datdo-is-coding/BEARING-CLASSIFICATION-SYSTEM/hardware/cad/models/tool.SLDASM

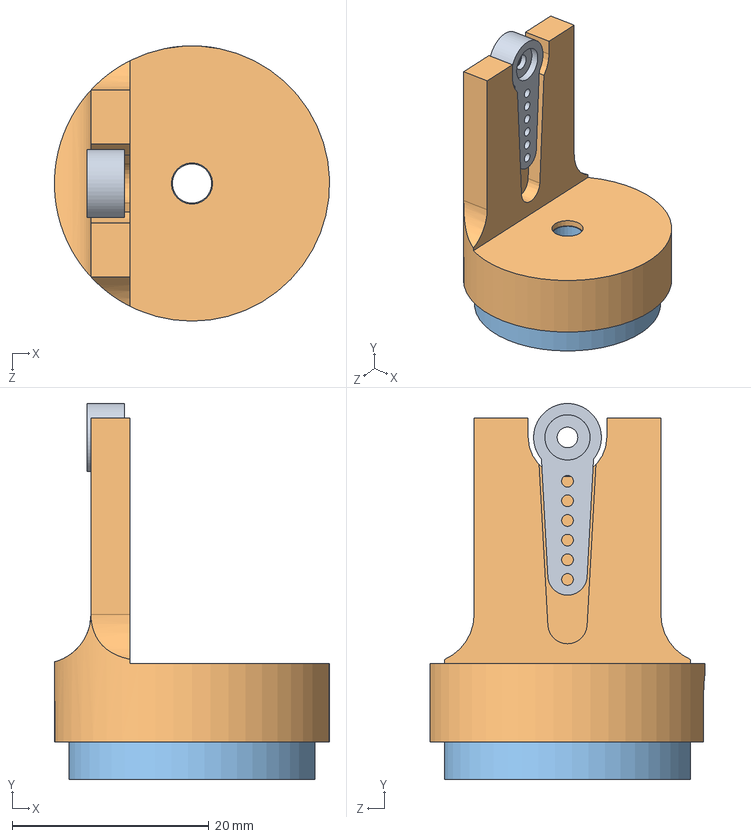
[picture p46: CAD file, 2026-10-25]
hardware/cad/models/tool.SLDASM
28.0 x 38.2 x 28.0 mm
SG90 - Micro Servo 9g - Tower Pro.2
arm4-1
magnet
