datdo-is-coding/BEARING-CLASSIFICATION-SYSTEM/hardware/cad/models/link3.SLDASM

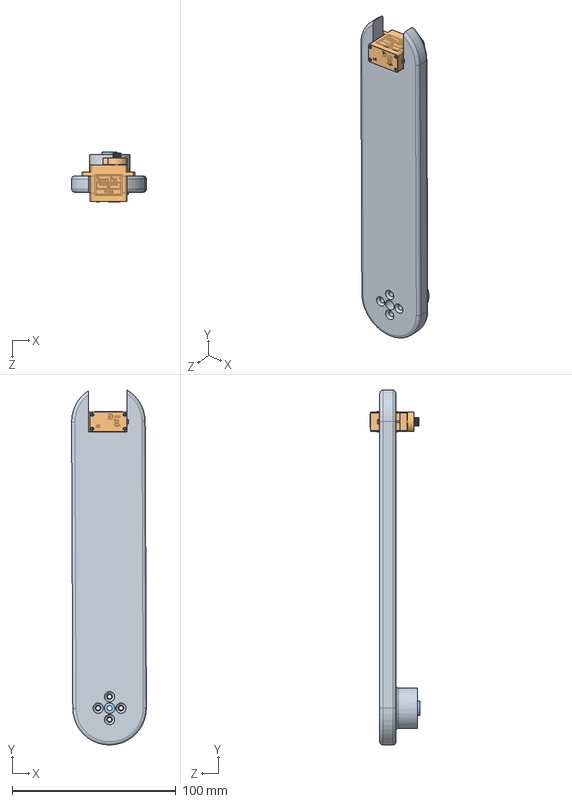
[picture p47: CAD file, 2026-10-25]
hardware/cad/models/link3.SLDASM
45.7 x 216.9 x 30.3 mm
arm bar
SG90 - Micro Servo 9g - Tower Pro.1
Servo horn v2.step
