datdo-is-coding/BEARING-CLASSIFICATION-SYSTEM/hardware/cad/models/link2.SLDASM

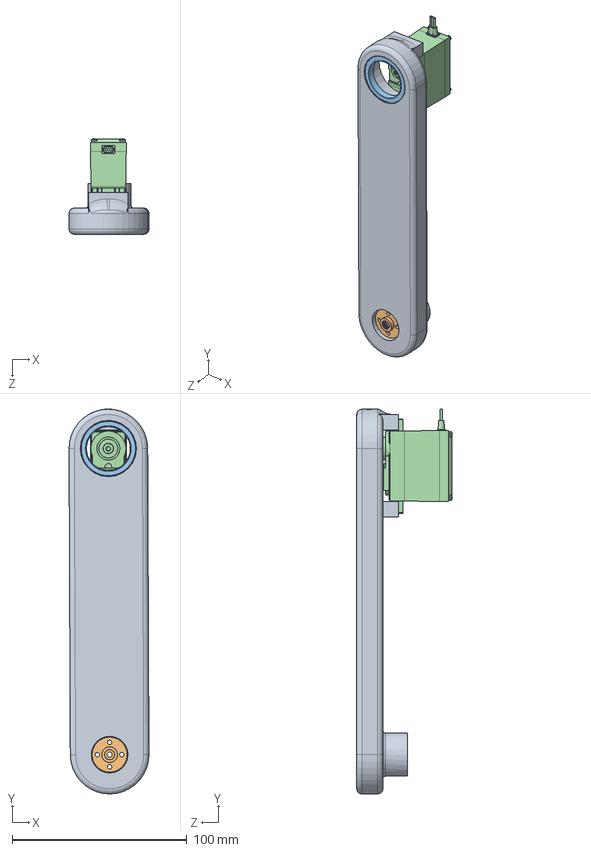
[picture p48: CAD file, 2026-10-25]
hardware/cad/models/link2.SLDASM
45.7 x 220.1 x 54.7 mm
arm bar
Servo horn v2.step
25x32x4
mg996R_v2
