datdo-is-coding/BEARING-CLASSIFICATION-SYSTEM/hardware/cad/link1.SLDASM

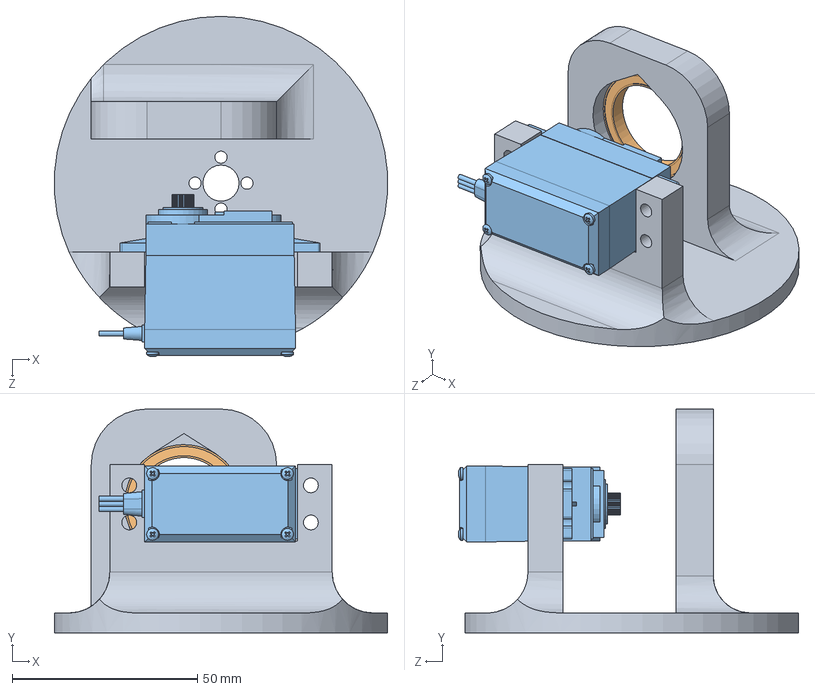
[picture p49: CAD file, 2026-10-25]
hardware/cad/link1.SLDASM
89.8 x 60.4 x 91.8 mm
arm2
25x32x4
mg996R_v2
