datdo-is-coding/BEARING-CLASSIFICATION-SYSTEM/hardware/cad/models/base_asm.SLDASM

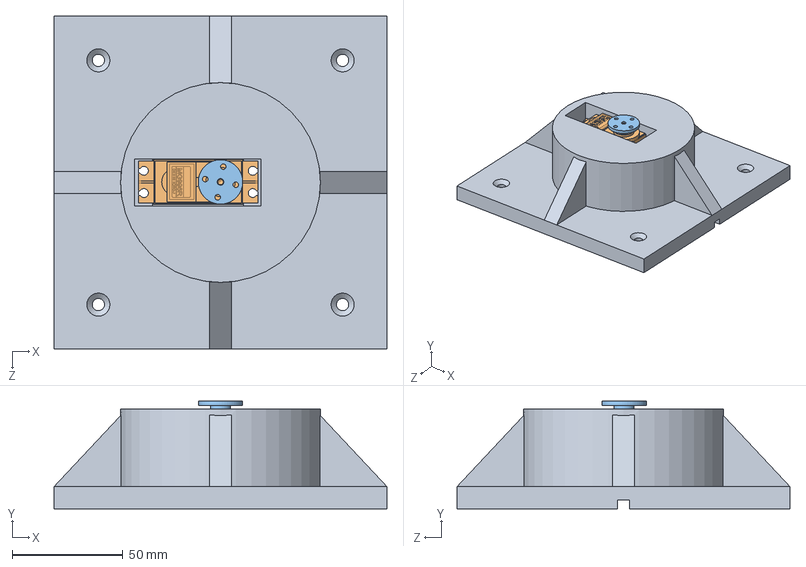
[picture p50: CAD file, 2026-10-25]
hardware/cad/models/base_asm.SLDASM
150.0 x 48.5 x 150.0 mm
base
mg996R_v2
Servo horn v2.step
