datdo-is-coding/BEARING-CLASSIFICATION-SYSTEM/hardware/cad/models/base_asm - Servo horn v2.step-1.STL

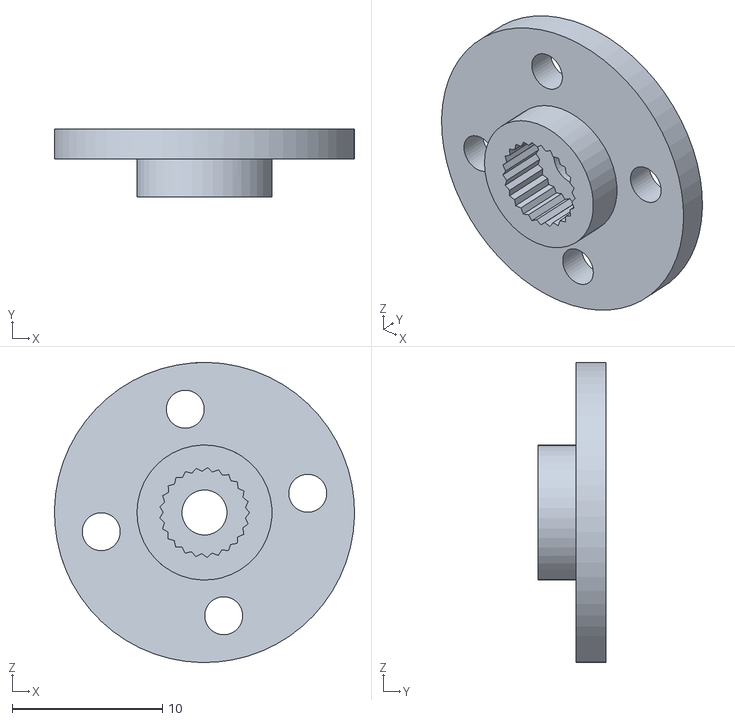
[picture p51: CAD file, 2026-10-25]
hardware/cad/models/base_asm - Servo horn v2.step-1.STL
20.0 x 4.50 x 20.0
