datdo-is-coding/BEARING-CLASSIFICATION-SYSTEM/hardware/cad/models/base_asm - mg996R_v2-1.STL

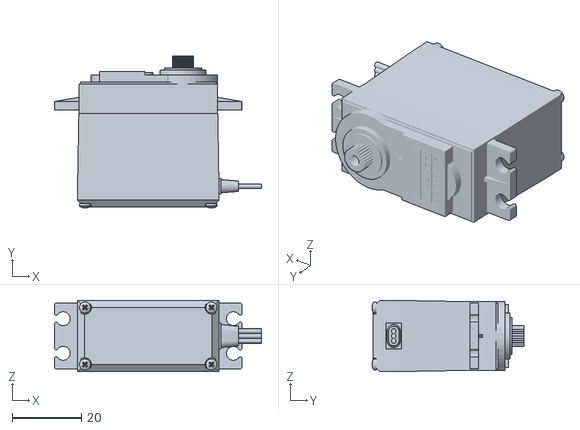
[picture p52: CAD file, 2026-10-25]
hardware/cad/models/base_asm - mg996R_v2-1.STL
59.6 x 43.8 x 20.5
