datdo-is-coding/BEARING-CLASSIFICATION-SYSTEM/hardware/cad/Assem1.SLDASM

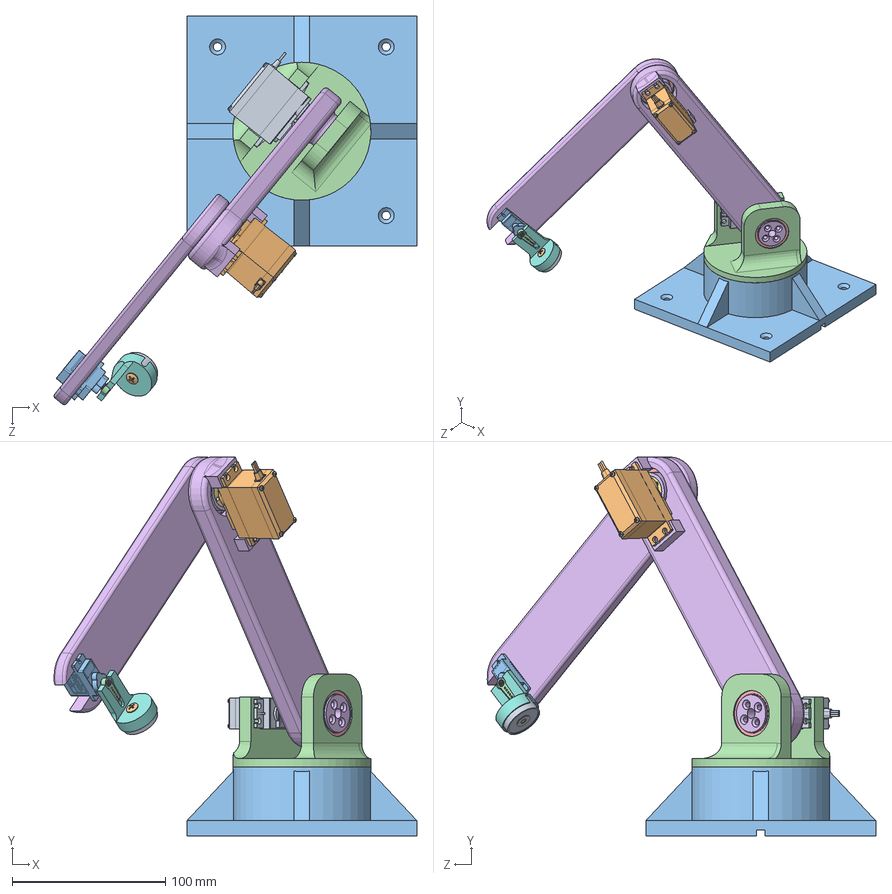
[picture p53: CAD file, 2026-10-25]
hardware/cad/Assem1.SLDASM
236.6 x 247.2 x 253.4 mm
mg996R_v2.step x 2
base
mg996R_v2
arm2
25x32x4 x 2
arm bar x 2
Servo horn v2.step x 3
arm4-1
magnet
countersunk raised head cross recess screw_iso
SG90 - Micro Servo 9g - Tower Pro.1_Pe_a.STEP
SG90 - Micro Servo 9g - Tower Pro.2_Pe_a.STEP
SG90 - Micro Servo 9g - Tower Pro.6_BS EN ISO 7045 - M2 x 4 - Z - 4S.STEP
