datdo-is-coding/BEARING-CLASSIFICATION-SYSTEM/hardware/cad/models/base_asm - base-1.STL

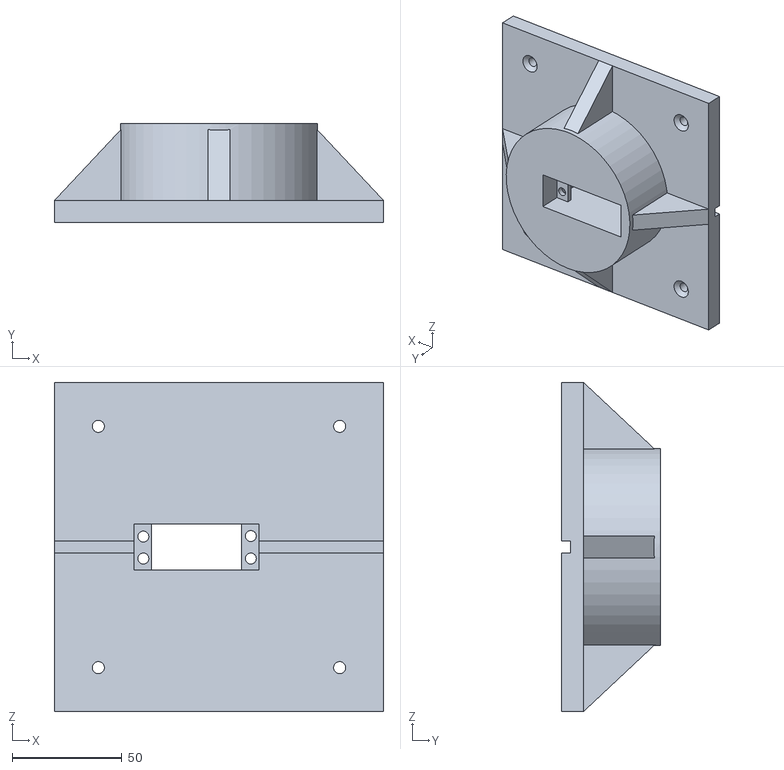
[picture p54: CAD file, 2026-10-25]
hardware/cad/models/base_asm - base-1.STL
150.0 x 45.0 x 150.0
