datdo-is-coding/BEARING-CLASSIFICATION-SYSTEM/hardware/cad/SG90.SLDASM

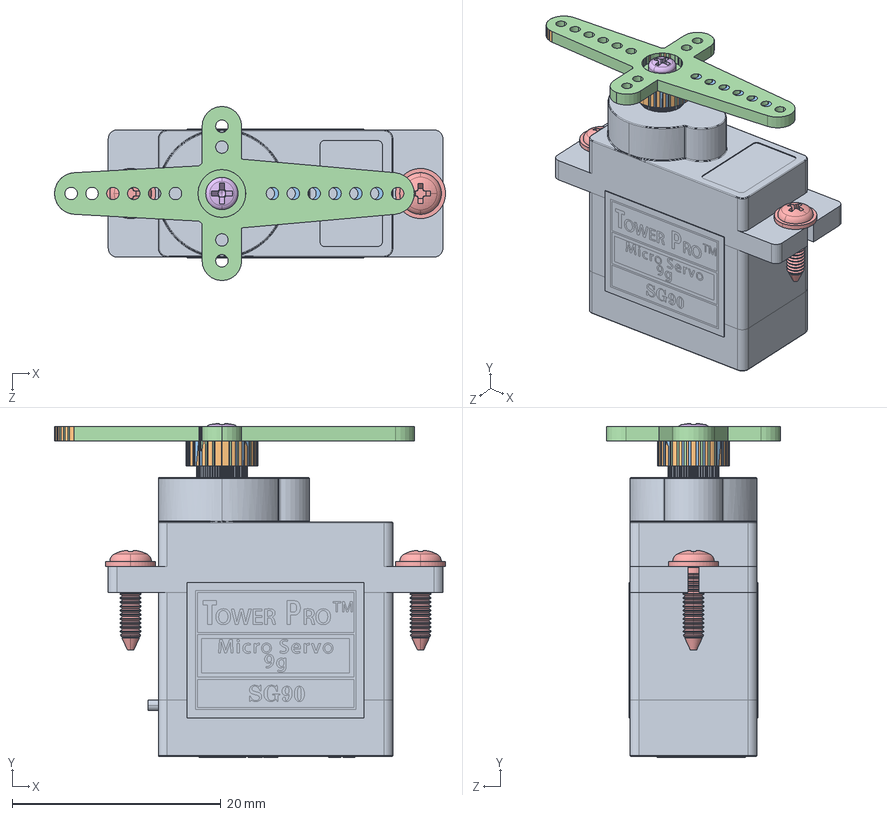
[picture p55: CAD file, 2026-10-25]
hardware/cad/SG90.SLDASM
37.5 x 32.0 x 16.7 mm
SG90 - Micro Servo 9g - Tower Pro.1_Pe_a.STEP
SG90 - Micro Servo 9g - Tower Pro.2_Pe_a.STEP
SG90 - Micro Servo 9g - Tower Pro.3_Pe_a.STEP
SG90 - Micro Servo 9g - Tower Pro.4_Pe_a.STEP
SG90 - Micro Servo 9g - Tower Pro.5_BS EN ISO 7045 - M2 x 8 - Z - 8S.STEP x 2
SG90 - Micro Servo 9g - Tower Pro.6_BS EN ISO 7045 - M2 x 4 - Z - 4S.STEP
