datdo-is-coding/BEARING-CLASSIFICATION-SYSTEM/hardware/cad/Assem2.SLDASM

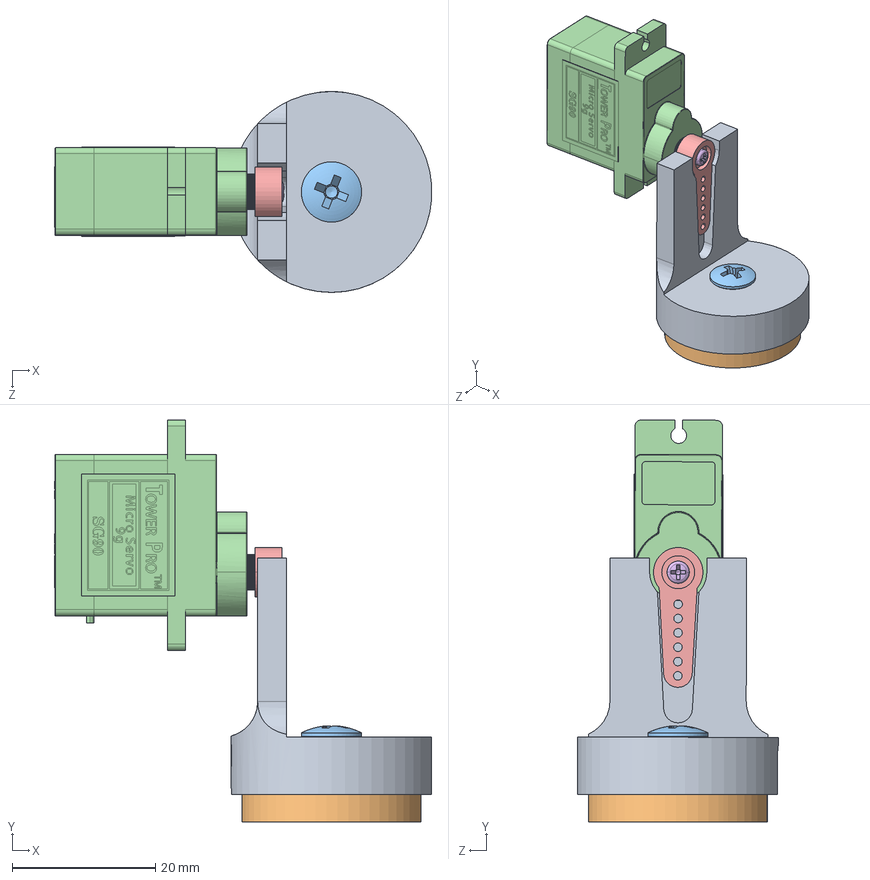
[picture p56: CAD file, 2026-10-25]
hardware/cad/Assem2.SLDASM
52.6 x 56.0 x 28.0 mm
arm4-1
magnet
countersunk raised head cross recess screw_iso
SG90 - Micro Servo 9g - Tower Pro.1_Pe_a.STEP
SG90 - Micro Servo 9g - Tower Pro.2_Pe_a.STEP
SG90 - Micro Servo 9g - Tower Pro.6_BS EN ISO 7045 - M2 x 4 - Z - 4S.STEP
