datdo-is-coding/BEARING-CLASSIFICATION-SYSTEM/hardware/cad/bearing_backward.SLDPRT

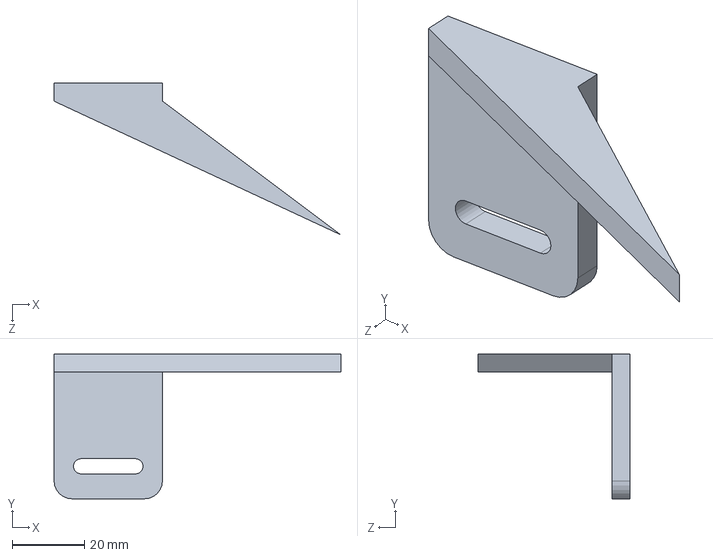
[picture p57: CAD file, 2026-11-04]
hardware/cad/bearing_backward.SLDPRT
79.3 x 40.0 x 42.0 mm
