datdo-is-coding/BEARING-CLASSIFICATION-SYSTEM/hardware/pcb/BIENDANG.DXF

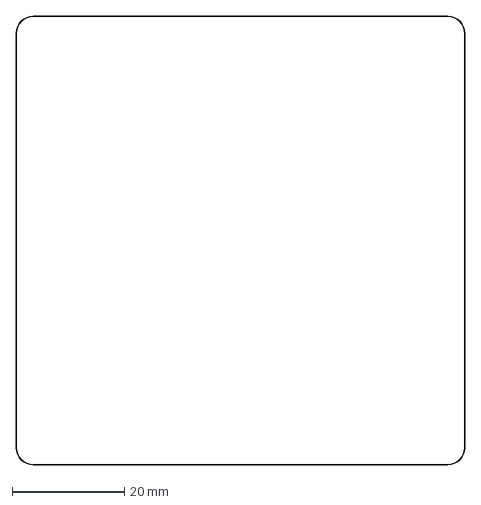
[picture p59: CAD file, 2026-10-25]
hardware/pcb/BIENDANG.DXF
80.0 x 80.0 mm
