datdo-is-coding/BEARING-CLASSIFICATION-SYSTEM/hardware/cad/bearing_.SLDPRT

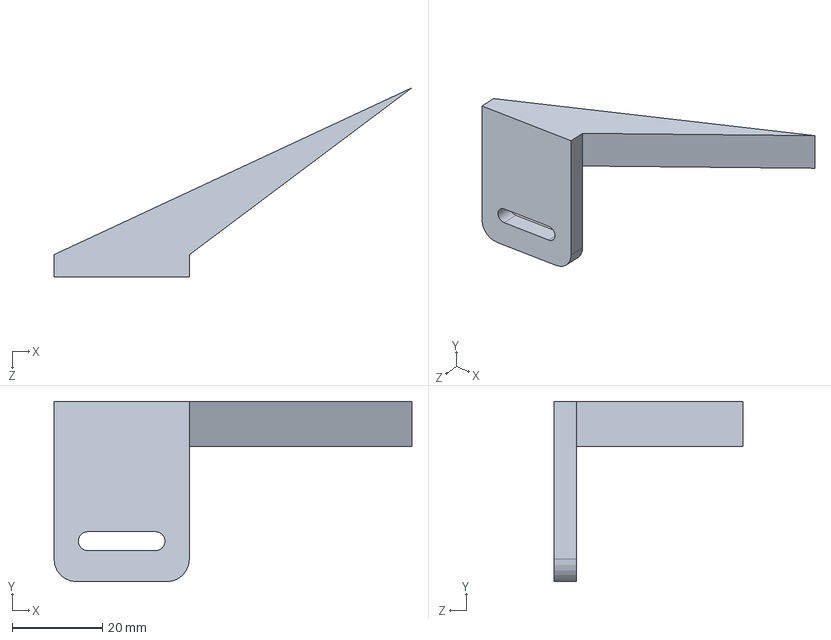
[picture p60: CAD file, 2026-11-04]
hardware/cad/bearing_.SLDPRT
79.3 x 40.0 x 42.0 mm
