datdo-is-coding/BEARING-CLASSIFICATION-SYSTEM/hardware/cad/arm bar.SLDPRT

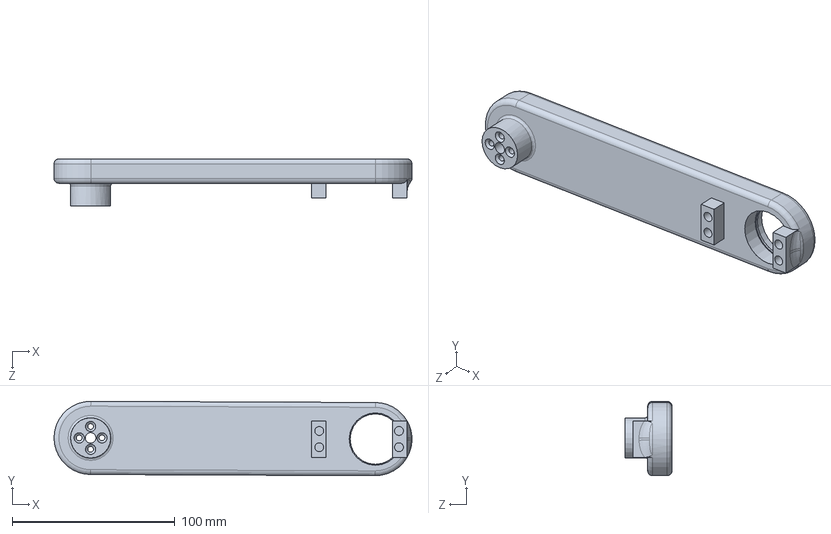
[picture p62: CAD file, 2026-10-25]
hardware/cad/arm bar.SLDPRT
220.0 x 45.7 x 29.0 mm
