datdo-is-coding/BEARING-CLASSIFICATION-SYSTEM/hardware/cad/25x32x4.SLDPRT

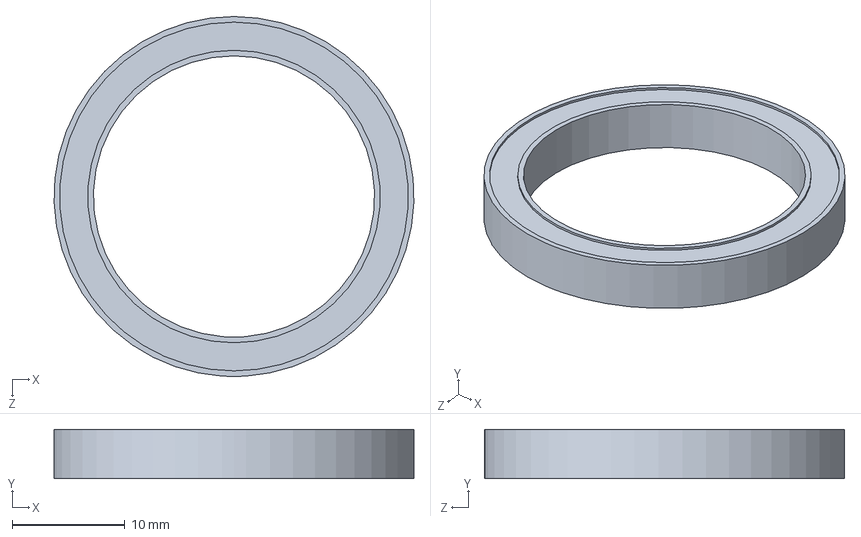
[picture p63: CAD file, 2026-10-25]
hardware/cad/25x32x4.SLDPRT
32.0 x 4.40 x 32.0 mm
