datdo-is-coding/BEARING-CLASSIFICATION-SYSTEM/hardware/cad/arm4-1.SLDPRT

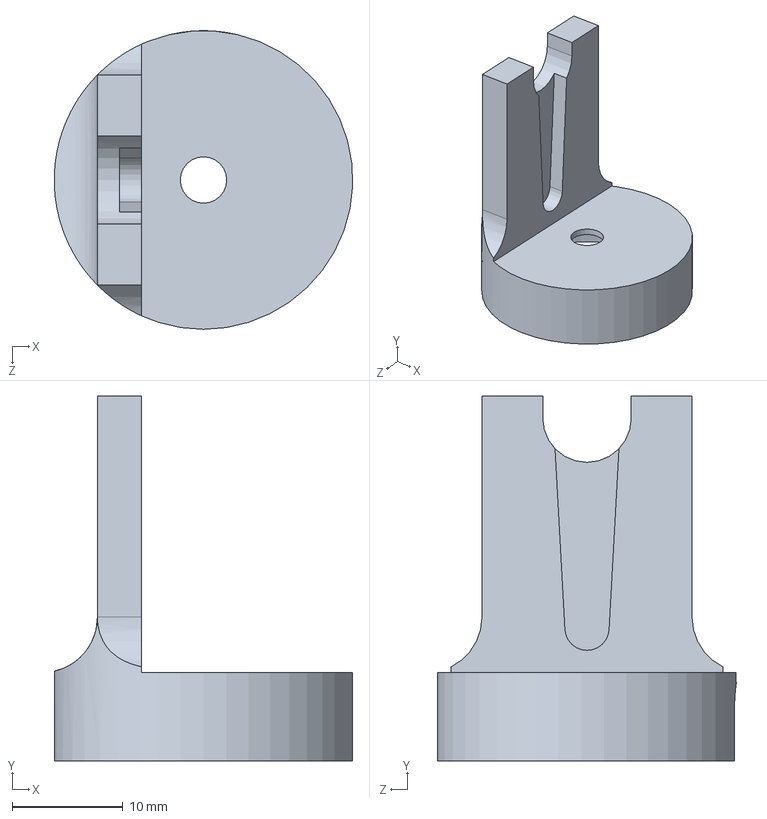
[picture p64: CAD file, 2026-10-25]
hardware/cad/arm4-1.SLDPRT
27.0 x 33.0 x 27.0 mm
