datdo-is-coding/BEARING-CLASSIFICATION-SYSTEM/hardware/cad/arm2.SLDPRT

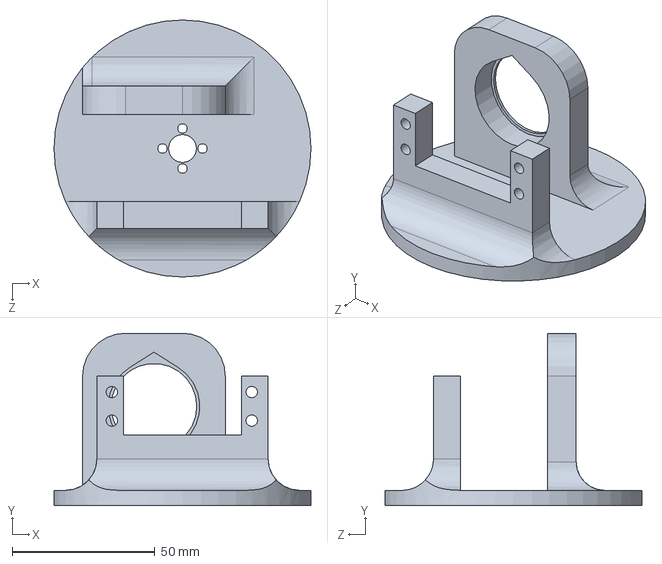
[picture p65: CAD file, 2026-10-25]
hardware/cad/arm2.SLDPRT
90.0 x 60.4 x 90.0 mm
