datdo-is-coding/BEARING-CLASSIFICATION-SYSTEM/hardware/cad/magnet.SLDPRT

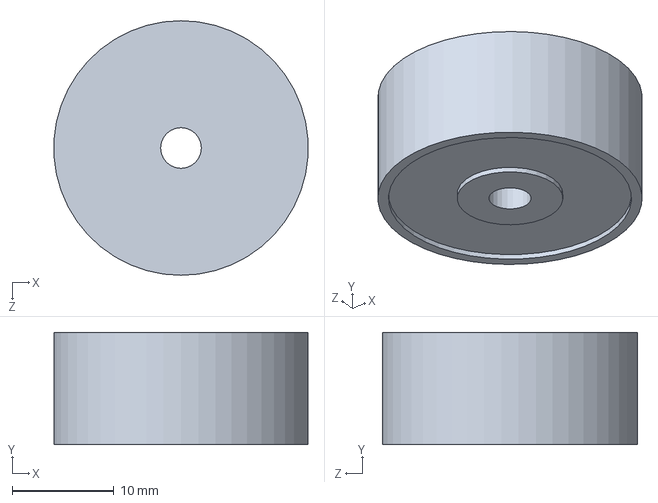
[picture p66: CAD file, 2026-10-25]
hardware/cad/magnet.SLDPRT
24.9 x 11.0 x 25.0 mm
