datdo-is-coding/BEARING-CLASSIFICATION-SYSTEM/(list of files, cad)

Other CAD files:
hardware/cad/SG90 - Micro Servo 9g - Tower Pro.STEP.SLDASM
software/RobotView/models/link2.STL
hardware/pcb/bien_dang_2.SLDPRT
software/RobotView/models/link3.STL
hardware/cad/mg996R_v2.SLDPRT
hardware/cad/models/SG90 - Micro Servo 9g - Tower Pro.1_Pe_a.STEP.SLDPRT
hardware/cad/Servo horn v2.step.SLDPRT
hardware/cad/base.SLDPRT
hardware/cad/bearing_.STL
hardware/cad/bearing_backward.STL
hardware/cad/models/base.STL
hardware/cad/models/base_asm.STL
hardware/cad/models/link1.SLDASM
hardware/cad/models/link1.STL
hardware/cad/models/tool.STL
hardware/pcb/bien_dang_2.DXF
