datdo-is-coding/BEARING-CLASSIFICATION-SYSTEM/training/experiments/yolo/yolo_v8n_rtx2050/results.csv

epoch | time | train/box_loss | train/cls_loss | train/dfl_loss | metrics/precision(B) | metrics/recall(B) | metrics/mAP50(B) | metrics/mAP50-95(B) | val/box_loss | val/cls_loss | val/dfl_loss | lr/pg0 | lr/pg1 | lr/pg2
1 | 40.7519 | 0.67608 | 0.88418 | 0.97271 | 0.98128 | 0.96369 | 0.99227 | 0.85485 | 0.57077 | 0.54228 | 0.86095 | 0.000663889 | 0.000663889 | 0.000663889
2 | 64.3407 | 0.69614 | 0.60759 | 0.97556 | 0.97337 | 0.96324 | 0.99079 | 0.84597 | 0.60291 | 0.48766 | 0.85498 | 0.00131738 | 0.00131738 | 0.00131738
3 | 85.8601 | 0.675 | 0.56515 | 0.96558 | 0.96708 | 0.97198 | 0.98582 | 0.8702 | 0.5164 | 0.44438 | 0.85625 | 0.00195768 | 0.00195768 | 0.00195768
4 | 107.582 | 0.66337 | 0.53071 | 0.9703 | 0.98166 | 0.95588 | 0.99015 | 0.86265 | 0.54041 | 0.45404 | 0.85874 | 0.0019406 | 0.0019406 | 0.0019406
5 | 129.641 | 0.66264 | 0.52166 | 0.97087 | 0.97436 | 0.97794 | 0.99227 | 0.86907 | 0.53011 | 0.38515 | 0.87491 | 0.0019208 | 0.0019208 | 0.0019208
6 | 151.043 | 0.64492 | 0.52097 | 0.9718 | 0.96809 | 0.97426 | 0.99262 | 0.87157 | 0.52002 | 0.39914 | 0.86816 | 0.001901 | 0.001901 | 0.001901
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
