datdo-is-coding/BEARING-CLASSIFICATION-SYSTEM/training/weights/resnet34/evaluation_test/test_predictions.csv

image_path | true_label | predicted_label | correct | confidence_percent
C:\work\code\python\NCKH_Phan_loai_vong_bi\data\resnet_dataset\test\damaged_shield\original_002482.jpg | damaged_shield | damaged_shield | True | 96.02
C:\work\code\python\NCKH_Phan_loai_vong_bi\data\resnet_dataset\test\damaged_shield\original_002483.jpg | damaged_shield | damaged_shield | True | 97.12
C:\work\code\python\NCKH_Phan_loai_vong_bi\data\resnet_dataset\test\damaged_shield\original_002484.jpg | damaged_shield | damaged_shield | True | 97.45
C:\work\code\python\NCKH_Phan_loai_vong_bi\data\resnet_dataset\test\damaged_shield\original_002485.jpg | damaged_shield | damaged_shield | True | 96.15
C:\work\code\python\NCKH_Phan_loai_vong_bi\data\resnet_dataset\test\damaged_shield\original_002486.jpg | damaged_shield | damaged_shield | True | 94.26
C:\work\code\python\NCKH_Phan_loai_vong_bi\data\resnet_dataset\test\damaged_shield\original_002487.jpg | damaged_shield | damaged_shield | True | 98.46
C:\work\code\python\NCKH_Phan_loai_vong_bi\data\resnet_dataset\test\damaged_shield\original_002488.jpg | damaged_shield | damaged_shield | True | 96.72
C:\work\code\python\NCKH_Phan_loai_vong_bi\data\resnet_dataset\test\damaged_shield\original_002489.jpg | damaged_shield | damaged_shield | True | 96.84
C:\work\code\python\NCKH_Phan_loai_vong_bi\data\resnet_dataset\test\damaged_shield\original_002490.jpg | damaged_shield | damaged_shield | True | 98.04
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
C:\work\code\python\NCKH_Phan_loai_vong_bi\data\resnet_dataset\test\damaged_shield\original_002519.jpg | damaged_shield | damaged_shield | True | 97.48
C:\work\code\python\NCKH_Phan_loai_vong_bi\data\resnet_dataset\test\damaged_shield\original_002520.jpg | damaged_shield | damaged_shield | True | 96.08
C:\work\code\python\NCKH_Phan_loai_vong_bi\data\resnet_dataset\test\damaged_shield\original_002521.jpg | damaged_shield | damaged_shield | True | 97.76
C:\work\code\python\NCKH_Phan_loai_vong_bi\data\resnet_dataset\test\damaged_shield\original_002522.jpg | damaged_shield | damaged_shield | True | 96.67
C:\work\code\python\NCKH_Phan_loai_vong_bi\data\resnet_dataset\test\damaged_shield\original_002523.jpg | damaged_shield | damaged_shield | True | 97.47
C:\work\code\python\NCKH_Phan_loai_vong_bi\data\resnet_dataset\test\damaged_shield\original_002524.jpg | damaged_shield | damaged_shield | True | 91.81
C:\work\code\python\NCKH_Phan_loai_vong_bi\data\resnet_dataset\test\normal\original_000487.jpg | normal | normal | True | 98.74
C:\work\code\python\NCKH_Phan_loai_vong_bi\data\resnet_dataset\test\normal\original_000488.jpg | normal | normal | True | 97.28
C:\work\code\python\NCKH_Phan_loai_vong_bi\data\resnet_dataset\test\normal\original_000489.jpg | normal | rusted | False | 37.43
C:\work\code\python\NCKH_Phan_loai_vong_bi\data\resnet_dataset\test\normal\original_000490.jpg | normal | normal | True | 95.01
C:\work\code\python\NCKH_Phan_loai_vong_bi\data\resnet_dataset\test\normal\original_000491.jpg | normal | normal | True | 95.52
C:\work\code\python\NCKH_Phan_loai_vong_bi\data\resnet_dataset\test\normal\original_000492.jpg | normal | normal | True | 95.88
C:\work\code\python\NCKH_Phan_loai_vong_bi\data\resnet_dataset\test\normal\original_000493.jpg | normal | normal | True | 97.23
C:\work\code\python\NCKH_Phan_loai_vong_bi\data\resnet_dataset\test\normal\original_000494.jpg | normal | normal | True | 93.94
C:\work\code\python\NCKH_Phan_loai_vong_bi\data\resnet_dataset\test\normal\original_000495.jpg | normal | normal | True | 68.36
C:\work\code\python\NCKH_Phan_loai_vong_bi\data\resnet_dataset\test\normal\original_000496.jpg | normal | normal | True | 96.24
C:\work\code\python\NCKH_Phan_loai_vong_bi\data\resnet_dataset\test\normal\original_000497.jpg | normal | normal | True | 91.74
C:\work\code\python\NCKH_Phan_loai_vong_bi\data\resnet_dataset\test\normal\original_000498.jpg | normal | normal | True | 94.89
C:\work\code\python\NCKH_Phan_loai_vong_bi\data\resnet_dataset\test\normal\original_000499.jpg | normal | normal | True | 66.96
C:\work\code\python\NCKH_Phan_loai_vong_bi\data\resnet_dataset\test\normal\original_000500.jpg | normal | normal | True | 87.56
C:\work\code\python\NCKH_Phan_loai_vong_bi\data\resnet_dataset\test\normal\original_000501.jpg | normal | normal | True | 94.09
C:\work\code\python\NCKH_Phan_loai_vong_bi\data\resnet_dataset\test\normal\original_000502.jpg | normal | normal | True | 55.15
C:\work\code\python\NCKH_Phan_loai_vong_bi\data\resnet_dataset\test\normal\original_000503.jpg | normal | normal | True | 97.21
C:\work\code\python\NCKH_Phan_loai_vong_bi\data\resnet_dataset\test\normal\original_000504.jpg | normal | normal | True | 93.94
C:\work\code\python\NCKH_Phan_loai_vong_bi\data\resnet_dataset\test\normal\original_000505.jpg | normal | normal | True | 82.37
C:\work\code\python\NCKH_Phan_loai_vong_bi\data\resnet_dataset\test\normal\original_000506.jpg | normal | rusted | False | 65.75
C:\work\code\python\NCKH_Phan_loai_vong_bi\data\resnet_dataset\test\normal\original_000507.jpg | normal | normal | True | 96.68
C:\work\code\python\NCKH_Phan_loai_vong_bi\data\resnet_dataset\test\normal\original_000508.jpg | normal | normal | True | 92.96
C:\work\code\python\NCKH_Phan_loai_vong_bi\data\resnet_dataset\test\normal\original_000509.jpg | normal | normal | True | 83.23
C:\work\code\python\NCKH_Phan_loai_vong_bi\data\resnet_dataset\test\normal\original_000510.jpg | normal | normal | True | 87.08
C:\work\code\python\NCKH_Phan_loai_vong_bi\data\resnet_dataset\test\normal\original_000511.jpg | normal | normal | True | 69.09
C:\work\code\python\NCKH_Phan_loai_vong_bi\data\resnet_dataset\test\normal\original_000512.jpg | normal | rusted | False | 90.78
C:\work\code\python\NCKH_Phan_loai_vong_bi\data\resnet_dataset\test\normal\original_000513.jpg | normal | normal | True | 96.17
C:\work\code\python\NCKH_Phan_loai_vong_bi\data\resnet_dataset\test\normal\original_000514.jpg | normal | normal | True | 97.92
C:\work\code\python\NCKH_Phan_loai_vong_bi\data\resnet_dataset\test\normal\original_000515.jpg | normal | normal | True | 95.7
C:\work\code\python\NCKH_Phan_loai_vong_bi\data\resnet_dataset\test\normal\original_000516.jpg | normal | normal | True | 95.5
C:\work\code\python\NCKH_Phan_loai_vong_bi\data\resnet_dataset\test\normal\original_000517.jpg | normal | normal | True | 99.1
C:\work\code\python\NCKH_Phan_loai_vong_bi\data\resnet_dataset\test\normal\original_000518.jpg | normal | normal | True | 92.91
C:\work\code\python\NCKH_Phan_loai_vong_bi\data\resnet_dataset\test\normal\original_000519.jpg | normal | normal | True | 91.07
C:\work\code\python\NCKH_Phan_loai_vong_bi\data\resnet_dataset\test\normal\original_000520.jpg | normal | normal | True | 97.08
C:\work\code\python\NCKH_Phan_loai_vong_bi\data\resnet_dataset\test\normal\original_000521.jpg | normal | normal | True | 86.82
C:\work\code\python\NCKH_Phan_loai_vong_bi\data\resnet_dataset\test\normal\original_000522.jpg | normal | normal | True | 76.69
C:\work\code\python\NCKH_Phan_loai_vong_bi\data\resnet_dataset\test\normal\original_000523.jpg | normal | normal | True | 97.57
C:\work\code\python\NCKH_Phan_loai_vong_bi\data\resnet_dataset\test\normal\original_000524.jpg | normal | normal | True | 92.09
C:\work\code\python\NCKH_Phan_loai_vong_bi\data\resnet_dataset\test\normal\original_000525.jpg | normal | normal | True | 96.14
C:\work\code\python\NCKH_Phan_loai_vong_bi\data\resnet_dataset\test\normal\original_000526.jpg | normal | normal | True | 64.28
C:\work\code\python\NCKH_Phan_loai_vong_bi\data\resnet_dataset\test\normal\original_000527.jpg | normal | normal | True | 96.83
C:\work\code\python\NCKH_Phan_loai_vong_bi\data\resnet_dataset\test\normal\original_000528.jpg | normal | normal | True | 96.49
C:\work\code\python\NCKH_Phan_loai_vong_bi\data\resnet_dataset\test\normal\original_000529.jpg | normal | normal | True | 98.17
C:\work\code\python\NCKH_Phan_loai_vong_bi\data\resnet_dataset\test\normal\original_000530.jpg | normal | normal | True | 96.48
C:\work\code\python\NCKH_Phan_loai_vong_bi\data\resnet_dataset\test\normal\original_000531.jpg | normal | surface_damage | False | 56.71
C:\work\code\python\NCKH_Phan_loai_vong_bi\data\resnet_dataset\test\normal\original_000532.jpg | normal | normal | True | 97.61
C:\work\code\python\NCKH_Phan_loai_vong_bi\data\resnet_dataset\test\rusted\original_001603.jpg | rusted | rusted | True | 79.91
C:\work\code\python\NCKH_Phan_loai_vong_bi\data\resnet_dataset\test\rusted\original_001604.jpg | rusted | rusted | True | 99.15
C:\work\code\python\NCKH_Phan_loai_vong_bi\data\resnet_dataset\test\rusted\original_001605.jpg | rusted | rusted | True | 93.87
C:\work\code\python\NCKH_Phan_loai_vong_bi\data\resnet_dataset\test\rusted\original_001606.jpg | rusted | rusted | True | 97.83
C:\work\code\python\NCKH_Phan_loai_vong_bi\data\resnet_dataset\test\rusted\original_001607.jpg | rusted | rusted | True | 97.04
C:\work\code\python\NCKH_Phan_loai_vong_bi\data\resnet_dataset\test\rusted\original_001608.jpg | rusted | rusted | True | 76.93
C:\work\code\python\NCKH_Phan_loai_vong_bi\data\resnet_dataset\test\rusted\original_001609.jpg | rusted | rusted | True | 97.88
C:\work\code\python\NCKH_Phan_loai_vong_bi\data\resnet_dataset\test\rusted\original_001610.jpg | rusted | rusted | True | 91.09
C:\work\code\python\NCKH_Phan_loai_vong_bi\data\resnet_dataset\test\rusted\original_001611.jpg | rusted | rusted | True | 96.21
C:\work\code\python\NCKH_Phan_loai_vong_bi\data\resnet_dataset\test\rusted\original_001612.jpg | rusted | rusted | True | 95.98
C:\work\code\python\NCKH_Phan_loai_vong_bi\data\resnet_dataset\test\rusted\original_001613.jpg | rusted | rusted | True | 94.46
C:\work\code\python\NCKH_Phan_loai_vong_bi\data\resnet_dataset\test\rusted\original_001614.jpg | rusted | rusted | True | 97.07
C:\work\code\python\NCKH_Phan_loai_vong_bi\data\resnet_dataset\test\rusted\original_001615.jpg | rusted | rusted | True | 96.13
C:\work\code\python\NCKH_Phan_loai_vong_bi\data\resnet_dataset\test\rusted\original_001616.jpg | rusted | rusted | True | 95.39
C:\work\code\python\NCKH_Phan_loai_vong_bi\data\resnet_dataset\test\rusted\original_001617.jpg | rusted | rusted | True | 95.92
C:\work\code\python\NCKH_Phan_loai_vong_bi\data\resnet_dataset\test\rusted\original_001618.jpg | rusted | rusted | True | 94.07
C:\work\code\python\NCKH_Phan_loai_vong_bi\data\resnet_dataset\test\rusted\original_001619.jpg | rusted | rusted | True | 92.18
C:\work\code\python\NCKH_Phan_loai_vong_bi\data\resnet_dataset\test\rusted\original_001620.jpg | rusted | rusted | True | 89.75
C:\work\code\python\NCKH_Phan_loai_vong_bi\data\resnet_dataset\test\rusted\original_001621.jpg | rusted | rusted | True | 96.63
C:\work\code\python\NCKH_Phan_loai_vong_bi\data\resnet_dataset\test\rusted\original_001622.jpg | rusted | rusted | True | 87.36
C:\work\code\python\NCKH_Phan_loai_vong_bi\data\resnet_dataset\test\rusted\original_001623.jpg | rusted | rusted | True | 95.78
C:\work\code\python\NCKH_Phan_loai_vong_bi\data\resnet_dataset\test\rusted\original_001624.jpg | rusted | rusted | True | 96.01
C:\work\code\python\NCKH_Phan_loai_vong_bi\data\resnet_dataset\test\rusted\original_001625.jpg | rusted | rusted | True | 96.02
C:\work\code\python\NCKH_Phan_loai_vong_bi\data\resnet_dataset\test\rusted\original_001626.jpg | rusted | rusted | True | 95.29
C:\work\code\python\NCKH_Phan_loai_vong_bi\data\resnet_dataset\test\rusted\original_001627.jpg | rusted | rusted | True | 96.87
C:\work\code\python\NCKH_Phan_loai_vong_bi\data\resnet_dataset\test\rusted\original_001628.jpg | rusted | rusted | True | 97.33
C:\work\code\python\NCKH_Phan_loai_vong_bi\data\resnet_dataset\test\rusted\original_001629.jpg | rusted | rusted | True | 95.21
C:\work\code\python\NCKH_Phan_loai_vong_bi\data\resnet_dataset\test\rusted\original_001630.jpg | rusted | rusted | True | 95.58
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
C:\work\code\python\NCKH_Phan_loai_vong_bi\data\resnet_dataset\test\surface_damage\original_002141.jpg | surface_damage | surface_damage | True | 45.36
