datdo-is-coding/BEARING-CLASSIFICATION-SYSTEM/training/experiments/yolo/yolo_v8n_rtx2050/BoxF1_curve.png

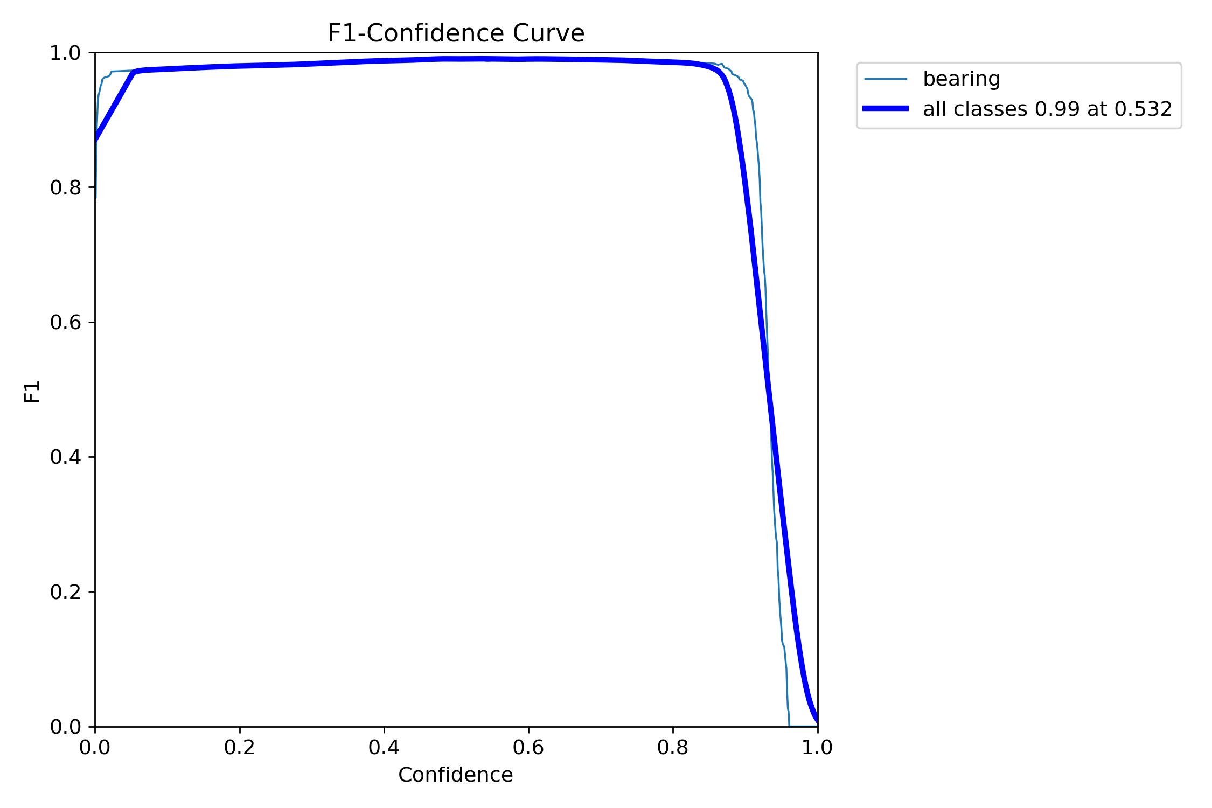
training/experiments/yolo/yolo_v8n_rtx2050/BoxF1_curve.png
