datdo-is-coding/BEARING-CLASSIFICATION-SYSTEM/training/experiments/yolo/yolo_v8n_rtx2050/BoxP_curve.png

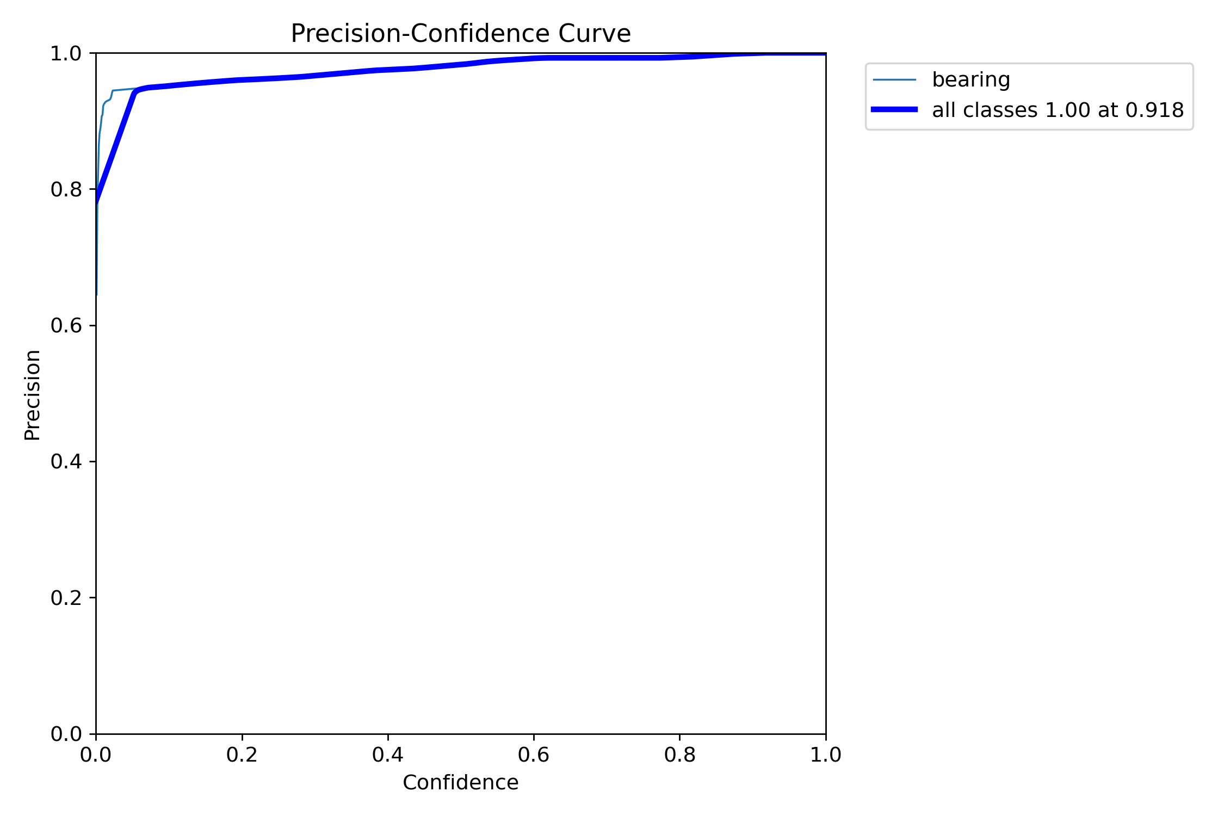
training/experiments/yolo/yolo_v8n_rtx2050/BoxP_curve.png
