datdo-is-coding/BEARING-CLASSIFICATION-SYSTEM/training/experiments/yolo/yolo_v8n_rtx2050/confusion_matrix.png

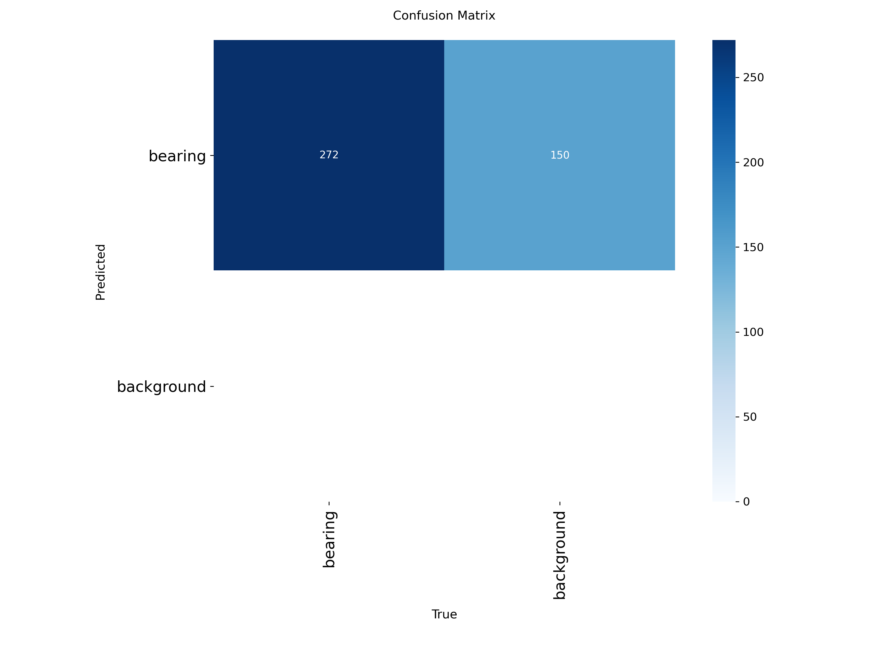
training/experiments/yolo/yolo_v8n_rtx2050/confusion_matrix.png
