datdo-is-coding/BEARING-CLASSIFICATION-SYSTEM/training/experiments/yolo/yolo_v8n_rtx2050/train_batch21601.jpg

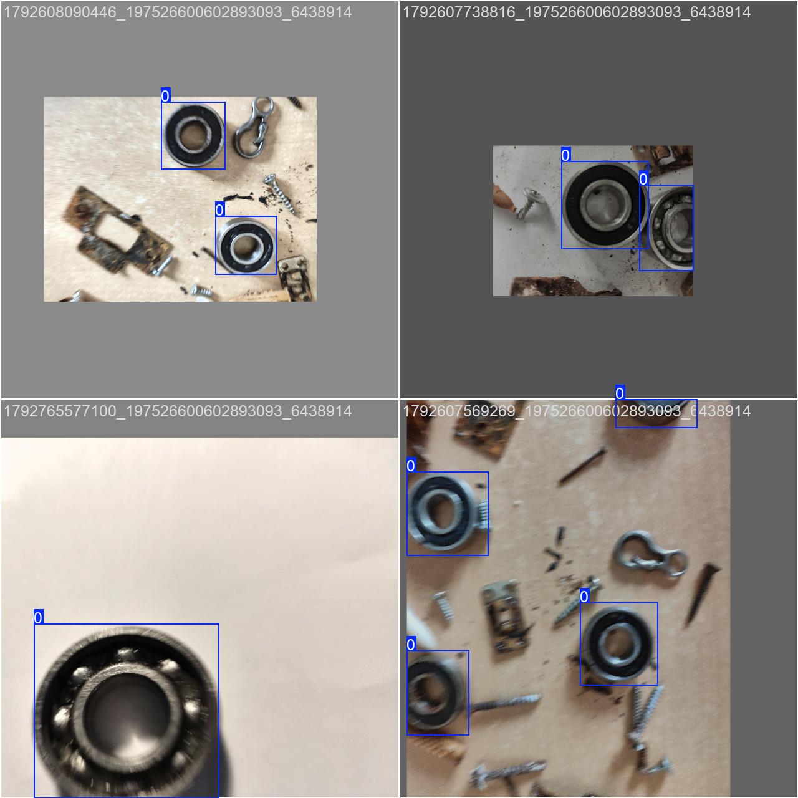
training/experiments/yolo/yolo_v8n_rtx2050/train_batch21601.jpg
