datdo-is-coding/BEARING-CLASSIFICATION-SYSTEM/training/experiments/yolo/yolo_v8n_rtx2050/val_batch2_labels.jpg

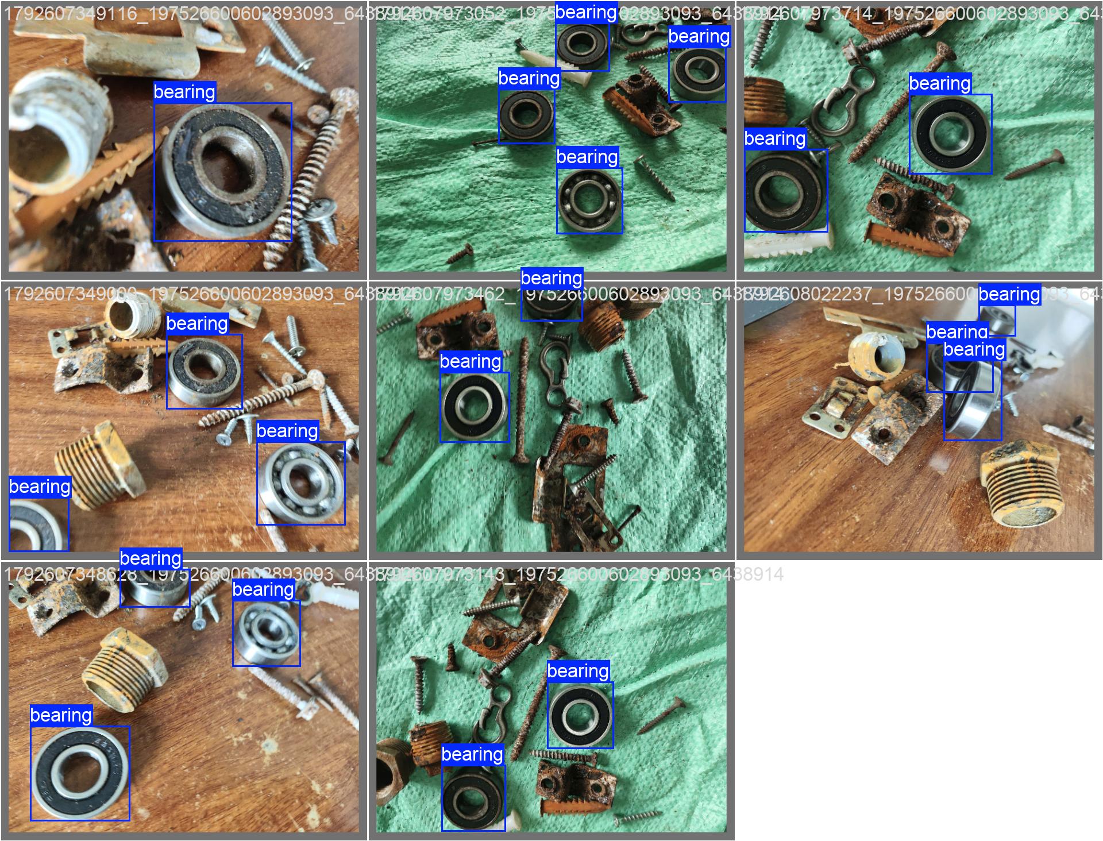
training/experiments/yolo/yolo_v8n_rtx2050/val_batch2_labels.jpg
