datdo-is-coding/BEARING-CLASSIFICATION-SYSTEM/training/weights/resnet34/evaluation_test/confusion_matrix.png

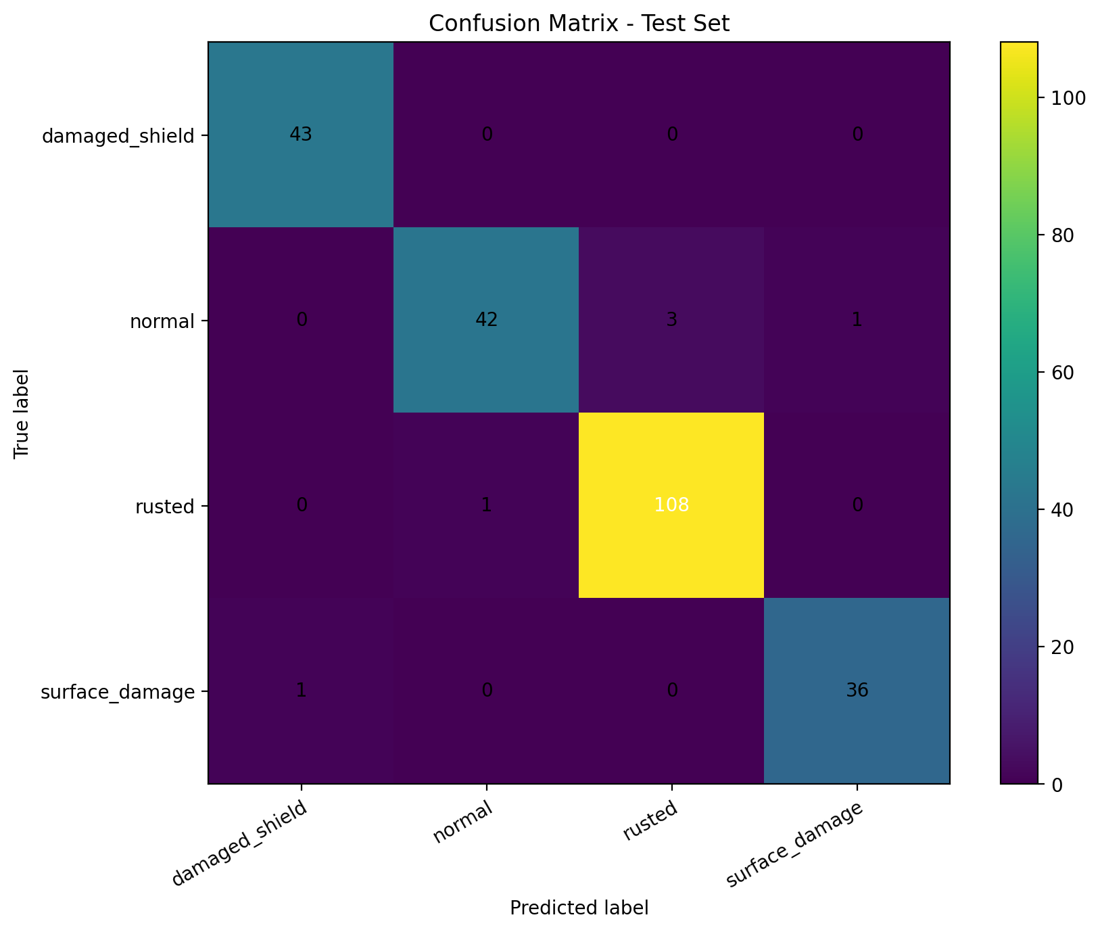
training/weights/resnet34/evaluation_test/confusion_matrix.png
