datdo-is-coding/BEARING-CLASSIFICATION-SYSTEM/training/weights/resnet34/training_history.csv

epoch | stage | train_loss | train_accuracy | val_loss | val_accuracy | learning_rate_backbone | learning_rate_classifier
1 | 1 | 1.038910014629364 | 0.5804166666666667 | 0.6881701941392859 | 0.8244897959183674 | 0.0 | 0.0003
2 | 1 | 0.7649432338774205 | 0.7435416666666667 | 0.653057996594176 | 0.8204081632653061 | 0.0 | 0.0003
3 | 2 | 0.5127466245243947 | 0.8820833333333333 | 0.5976902192952681 | 0.8571428571428571 | 1e-05 | 3e-05
4 | 2 | 0.37190070800483227 | 0.9483333333333334 | 0.40361373290723684 | 0.9428571428571428 | 1e-05 | 3e-05
5 | 2 | 0.3235691116005182 | 0.965625 | 0.38983216273541355 | 0.9469387755102041 | 1e-05 | 3e-05
6 | 2 | 0.29361193574965 | 0.979375 | 0.38363398301358126 | 0.9551020408163265 | 1e-05 | 3e-05
7 | 2 | 0.2727051088958979 | 0.98625 | 0.36942511869936573 | 0.9591836734693877 | 1e-05 | 3e-05
8 | 2 | 0.2642193177094062 | 0.9866666666666667 | 0.35110672177100666 | 0.9551020408163265 | 1e-05 | 3e-05
9 | 2 | 0.2572107466806968 | 0.98875 | 0.3584694171438412 | 0.9591836734693877 | 1e-05 | 3e-05
10 | 2 | 0.24951302806536357 | 0.990625 | 0.3539837536763172 | 0.963265306122449 | 5e-06 | 1.5e-05
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
