datdo-is-coding/BEARING-CLASSIFICATION-SYSTEM/hardware/pcb/robot4dof.kicad_pcb

## KiCad design hardware/pcb/robot4dof.kicad_pcb (2026-10-25)

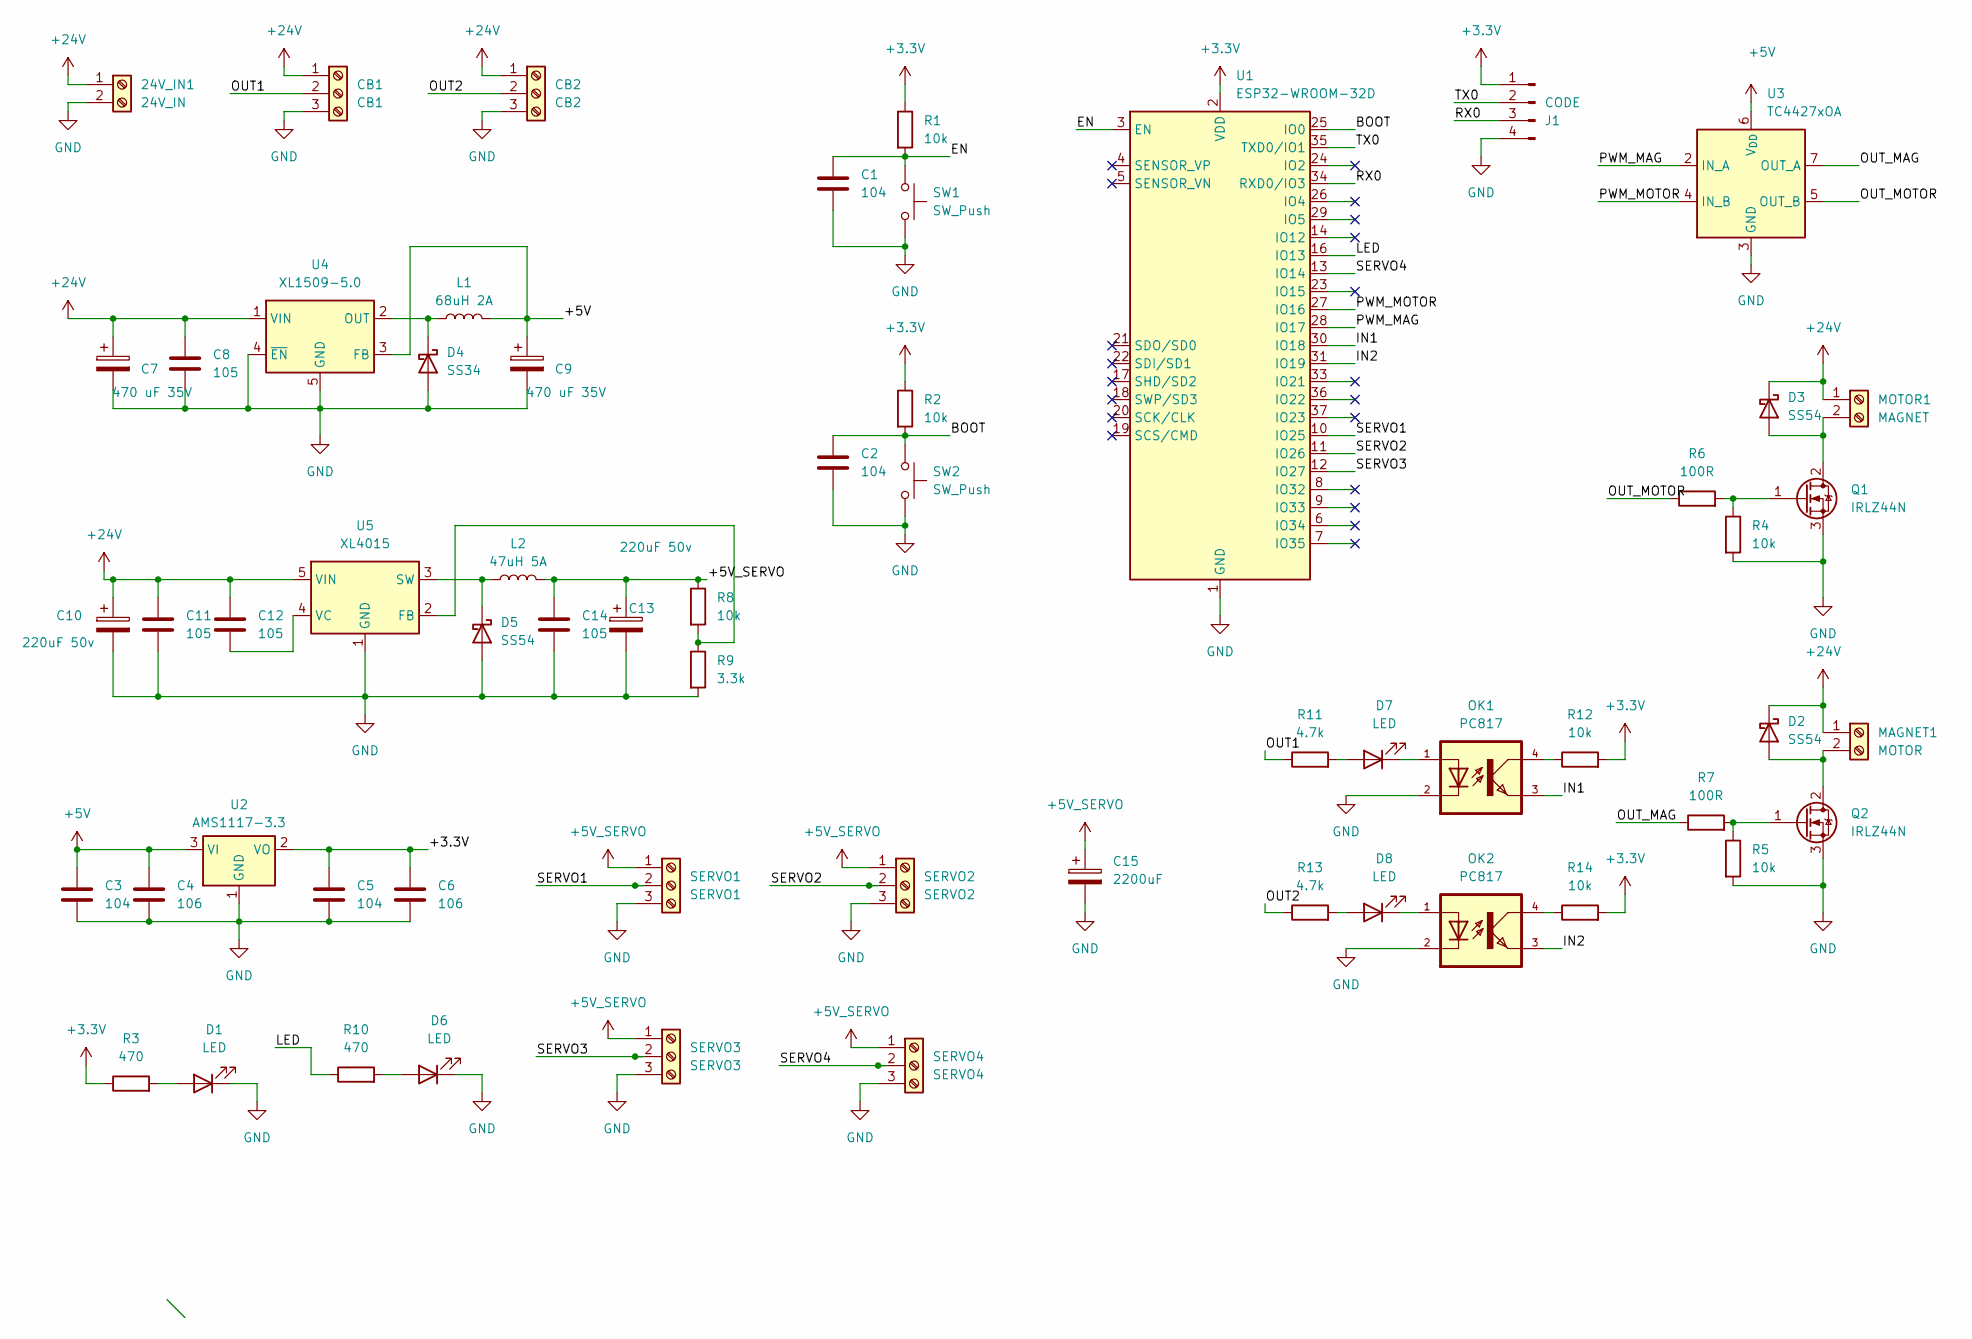
[picture p82: schematic robot4dof.kicad_sch]

Parts:
24V_IN1: 24V_IN; TerminalBlock_TE_282834-2_1x02_P2.54mm_Horizontal
C1, C2, C3, C5: 104; C_0805_2012Metric_Pad1.18x1.45mm_HandSolder
C4, C6: 106; C_0805_2012Metric_Pad1.18x1.45mm_HandSolder
C7, C9: 470 uF 35V; CP_Elec_8x10.5
C8, C11, C12, C14: 105; C_0805_2012Metric_Pad1.18x1.45mm_HandSolder
C10, C13: 220uF 50v; CP_Elec_8x10.5
C15: 2200uF; C_Radial_D10.0mm_H20.0mm_P5.00mm
CB1: CB1; TerminalBlock_TE_282834-3_1x03_P2.54mm_Horizontal
CB2: CB2; TerminalBlock_TE_282834-3_1x03_P2.54mm_Horizontal
D1, D6, D7, D8: LED; LED_0805_2012Metric_Pad1.15x1.40mm_HandSolder
D2, D3, D5: SS54; D_SMA_Handsoldering
D4: SS34; D_SMA_Handsoldering
J1: CODE; PinHeader_1x04_P2.54mm_Vertical
L1: 68uH 2A; L_7.3x7.3_H3.5
L2: 47uH 5A; L_Toroid_Vertical_L21.6mm_W9.1mm_P8.40mm_Bourns_5700
MAGNET1: MOTOR; TerminalBlock_TE_282834-2_1x02_P2.54mm_Horizontal
MOTOR1: MAGNET; TerminalBlock_TE_282834-2_1x02_P2.54mm_Horizontal
OK1, OK2: PC817; DIL04; MPN PC817X4J000F
Q1, Q2: IRLZ44N; TO-220-3_Vertical
R1, R2, R4, R5, R8, R12, R14: 10k; R_0805_2012Metric_Pad1.20x1.40mm_HandSolder
R3, R10: 470; R_0805_2012Metric_Pad1.20x1.40mm_HandSolder
R6, R7: 100R; R_0805_2012Metric_Pad1.20x1.40mm_HandSolder
R9: 3.3k; R_0805_2012Metric_Pad1.20x1.40mm_HandSolder
R11, R13: 4.7k; R_0805_2012Metric_Pad1.20x1.40mm_HandSolder
SERVO1: SERVO1; TerminalBlock_TE_282834-3_1x03_P2.54mm_Horizontal
SERVO2: SERVO2; TerminalBlock_TE_282834-3_1x03_P2.54mm_Horizontal
SERVO3: SERVO3; TerminalBlock_TE_282834-3_1x03_P2.54mm_Horizontal
SERVO4: SERVO4; TerminalBlock_TE_282834-3_1x03_P2.54mm_Horizontal
SW1, SW2: SW_Push; SW_Tactile_SPST_NO_Straight_CK_PTS636Sx25SMTRLFS
U1: ESP32-WROOM-32D
U2: AMS1117-3.3; SOT-223-3_TabPin2
U3: TC4427xOA; SOIC-8_3.9x4.9mm_P1.27mm
U4: XL1509-5.0; SOIC-8_3.9x4.9mm_P1.27mm
U5: XL4015; TO-263-5_TabPin3

Connections:
+3.3V: C5.1, C6.1, J1.1, R1.1, R2.1, R3.1, R12.2, R14.2, U1.2 (VDD), U2.2 (VO)
+5V: C3.1, C4.1, C9.1, L1.2, U2.3 (VI), U3.6 (V_{DD}), U4.3 (FB)
+5V_SERVO: C13.1, C14.1, C15.1, L2.2, R8.1, SERVO1.1, SERVO2.1, SERVO3.1, SERVO4.1
+24V: 24V_IN1.1, C7.1, C8.1, C10.1, C11.1, C12.1, CB1.1, CB2.1, D2.1 (K), D3.1 (K), MAGNET1.1, MOTOR1.1, U4.1 (VIN), U5.5 (VIN)
/BOOT: C2.1, R2.2, SW2.1, U1.25 (IO0)
/EN: C1.1, R1.2, SW1.1, U1.3 (EN)
/IN1: OK1.3, U1.30 (IO18)
/IN2: OK2.3, U1.31 (IO19)
/LED: R10.1, U1.16 (IO13)
/OUT1: CB1.2, R11.1
/OUT2: CB2.2, R13.1
/OUT_MAG: R7.1, U3.7 (OUT_A)
/OUT_MOTOR: R6.1, U3.5 (OUT_B)
/PWM_MAG: U1.28 (IO17), U3.2 (IN_A)
/PWM_MOTOR: U1.27 (IO16), U3.4 (IN_B)
/RX0: J1.3, U1.34 (RXD0/IO3)
/SERVO1: SERVO1.2, U1.10 (IO25)
/SERVO2: SERVO2.2, U1.11 (IO26)
/SERVO3: SERVO3.2, U1.12 (IO27)
/SERVO4: SERVO4.2, U1.13 (IO14)
/TX0: J1.2, U1.35 (TXD0/IO1)
GND: 24V_IN1.2, C1.2, C2.2, C3.2, C4.2, C5.2, C6.2, C7.2, C8.2, C9.2, C10.2, C11.2, C13.2, C14.2, C15.2, CB1.3, CB2.3, D1.1 (K), D4.2 (A), D5.2 (A), D6.1 (K), J1.4, OK1.2, OK2.2, Q1.3 (S), Q2.3 (S), R4.2, R5.2, R9.2, SERVO1.3, SERVO2.3, SERVO3.3, SERVO4.3, SW1.2, SW2.2, U1.1 (GND), U1.15 (GND), U1.38 (GND), U1.39 (GND), U2.1 (GND), U3.3 (GND), U4.4 (~EN), U4.5 (GND), U4.6 (GND), U4.7 (GND), U4.8 (GND), U5.1 (GND)
unnamed: D1.2 (A), R3.2
unnamed: D2.2 (A), MAGNET1.2, Q2.2 (D)
unnamed: D3.2 (A), MOTOR1.2, Q1.2 (D)
unnamed: D4.1 (K), L1.1, U4.2 (OUT)
unnamed: D5.1 (K), L2.1, U5.3 (SW)
unnamed: D6.2 (A), R10.2
unnamed: D7.2 (A), R11.2
unnamed: D7.1 (K), OK1.1
unnamed: D8.2 (A), R13.2
unnamed: D8.1 (K), OK2.1
unnamed: OK1.4, R12.1
unnamed: OK2.4, R14.1
unnamed: Q1.1 (G), R4.1, R6.2
unnamed: Q2.1 (G), R5.1, R7.2
unnamed: R8.2, R9.1, U5.2 (FB)
unnamed: C12.2, U5.4 (VC)

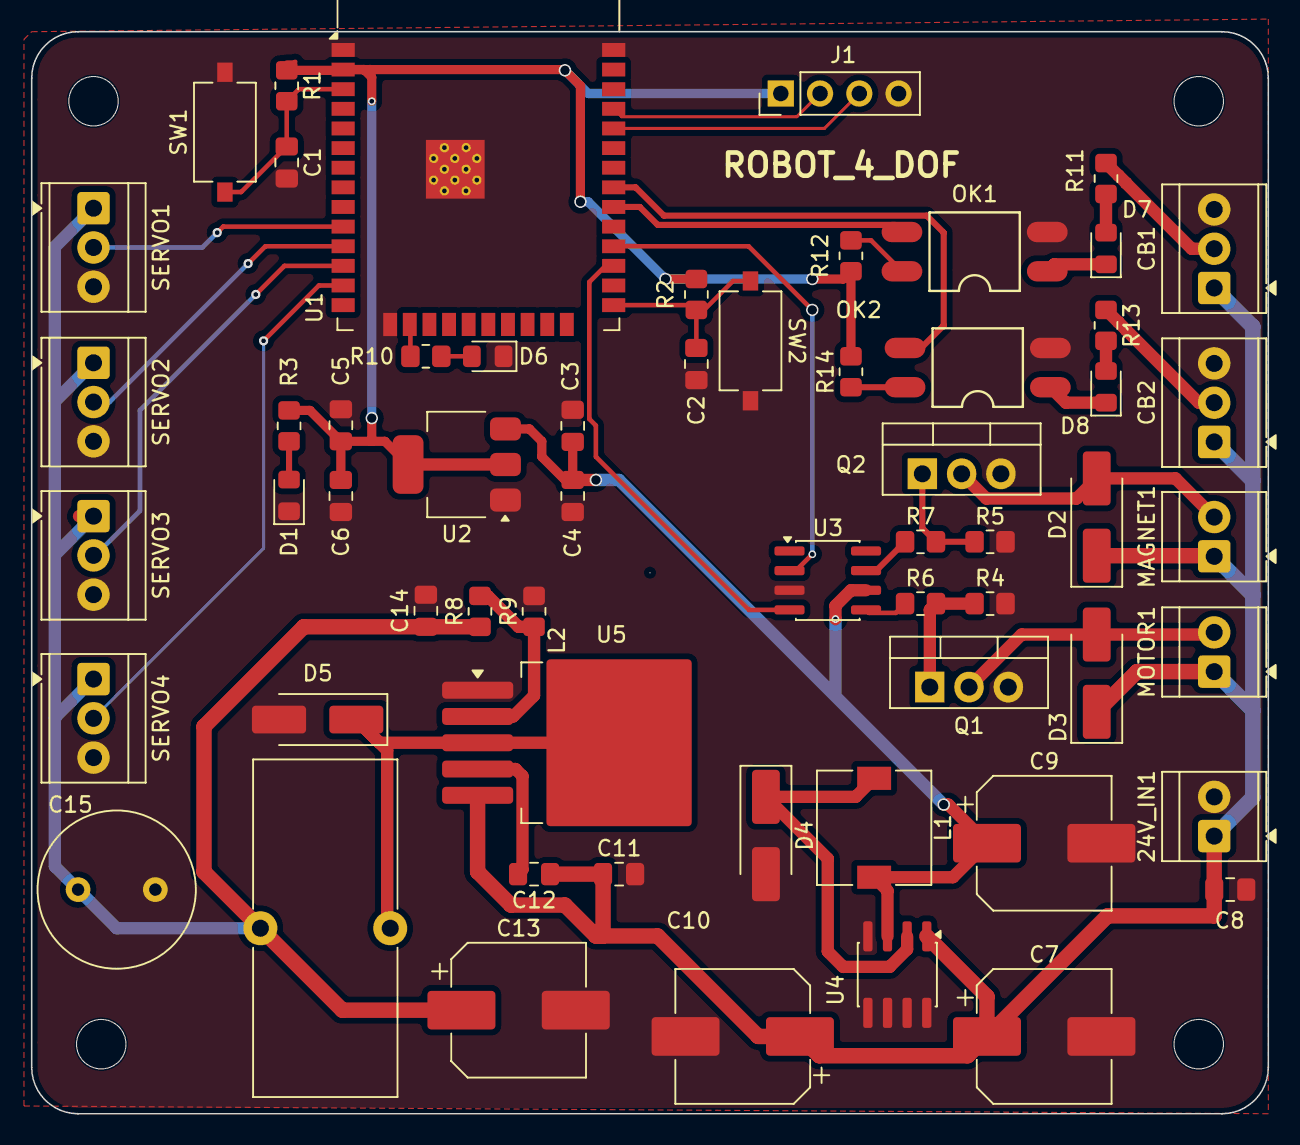
[picture p83: board robot4dof.kicad_pcb from above]

Board: 2 copper layers, 80.0 x 70.0 mm, 60 parts (0 on the bottom side), 38 nets.
